DaniilKorshkov/Urania/Urania specs.odt

-Dependencies:

Graphic user interface depends on streamlit for creating web application;

on matplotlib for plotting graphs;

on pandas for creating tables;

Backend depends on pyvisa, python-netdiscover

I recommend running Streamlit GUI through Brave browser instead of Firefox, as Brave do not crash when Streamlit server is stopped

Urania desktop is controlled remotely through RustDesk (free open source analog of TeamViewer). Password and 2FA security policies to be established later

Structure of software:

Sampling system is operated by 2 independent programs that communicate one with another through JSON files.

One program is responsible for data collection (changing sample, operating VSC, inquering data from RGA and Ox. analyzer), another one is responsible for data visualisation and graphic user interface.

Structure of libraries:

The code consists of the following libraries: AbnormalityReaction.py; Functions.py; GUI_Settings_Menu.py; JSONoperators.py; main.py; RGA_comms.py; VSC_comms.py; StreamlitGUI.py, TaskManagement.py, oxygen_analyzer.py, SpectrumsManager.py, VSC_Gui_Operation.py

AbnormalityReaction.py library is responsible for finding abnormalities in mass spectrometer readings and report them to user

FindAbnormalityInSpectrum function inputs a single spectrum as dictionary; date and time of this spectrum; filename of log; filename of file with quality standarts and options

This functions compares each PPM reading for integer molar masses in spectrum to tolerance boundaries set in the quality standarts file.

This function may run in ambient and on-demand mode, depending whether DoReportToJSON is True or False. If True, function is supposed to run right after spectrum is obtained. It reports all abnormalities to JSON log. If False, function is supposed to run on-demand via GUI; and display all abnormalities to user via GUI

Functions.py library contains functions that do not fit into any other library.

get_time_list function inputs list of spectrums and returns list of corresponding moments of time; at which those spectrums were recorded

plot_mass function inputs list of spectrums and desired index; and outputs the list of PPM’s corresponding to given index. For example, it can return all third elements

from list of lists.

GUI_Settings_Menu.py library is responsible for settings menu that runs through graphic user interface. It contains functions to modify JSON settings config that other pages rely on.

reset_to_default function erases currently used JSON config and overwrites it with factiory default JSON config

apply_page_settings function replaces given line in JSON config with desired line. Different lines in JSON config correspond to different pages of GUI. It reads old JSON config and makes full copy of it with exception of desired line; then, overwriting old config with this copy.

modify_* functions input Settings dictionary for given line (obtained before) and Settings filename. Those functions let user change given parameter, and then call apply_page_settings function to make changes to JSON config

Settings_Page function is a ready–to–use Settings menu that runs through Streamlit

JSONoperators.py library is responsible for working with JSON files.

read_spectrum_json function reads all spectrums from JSON file that contains list of spectrums

read_last_spectrums function reads the specified amount of last spectrums from JSON file. It calls read_spectrum_json function and cuts off the unwanted spectrums

read_period_of_time function reads specified amount of spectrums starting from specified moment of time from JSON file. For example, it may read 10 most recent spectrums starting from 01 Jun 2024, 14:00:00.

read_all_page_numbers function reads numbers of all pages that are specified in given JSON config

main.py file runs the main page of graphic user interface

RGA_comms.py library is responsible for sending commands to gas analyser and receiving data from it.

SendPacketsToRGA function inputs a list of str commands. This functions converts those commands to bytes and sends to RGA via TCP protocol.

This function saves all responses from RGA to received_list and returns it.

This function can execute internal commands such as __listen__ or __wait_for_given_mass__. Using those functions, user can control how commands are sent to RGA; and how output is received.

This function raises an error if “ERROR” keyword is detected in output.

GetMassSpectrum function creates a list of prompts for mass spectrometer to receive a mass spectrum with specified initial mass, amount of steps, step length and accuracy. It sends this list of prompts to RGA; receives output, converts the output to required format and

AppendSpectrumJSON function reads specifications (initial mass, amount of steps, step length and accuracy) from metadata in spectrum JSON file; calls GetMassSpectrum to get spectrum and writes this spectrum to JSON file

VSC_comms library is responsible for communication with vaccuum control system

SendCommand function is responsible for sending individual command to vaccuum system controller.

Functions with read and change keyword in this library are responsible for individual actions (open/close/setpoint of single device, read pressure and mass flow of single device and etc.) on connected devices.

ConvertEngineerNotation and ConvertToEngNotation are technical functions, responsible for converting numbers from Python format to format, used by VSC

StabilizePressure is an experimental function that gradually closes an MFC until target pressure is reached at Pressure Controller. Right now there are no plans to use it

IncreaseFlowRate is an experimental function that gradually opens an MFC while maintaining target pressure at Pressure Controller. Right now there are no plans to use it

SmartCloseMFC is a function that partially or fully closes MFC such that pressure on Pressure Controller will not exceed 760 torr. It relies on experimentally obtained function to do so.

FullQuery is a function that displays all data from all sensors.

VSC_Manual_Operation is a program that should be run through terminal with sudo privileges. It displays all data about VSC and lets user manually operate it.

oxygen_analyzer.py library is responsible for inquiring oxygen concentration from oxygen analyzer

GUI_Task_Manager.py is responsible for managing tasks through web application

VSC_Gui_Operation.py is responsible for controlling vsc and multi inlet valve through web application

Technical.py page is responsible for pinging RGA and detecting it’s IP address. It is a separate page for fail safety

StreamlitGUI.py library is responsible for data visualisation through web application.

date_time_input function create widgets for date input and time inputs; allowing user to search for scans made at given moment of time

constant_time_spectrum function plots a graph with molar mass at X axis and PPM at Y axis for specified moment of time. Using slider, user can scroll through different moments of time

constant_time_spectrum_table prints table with numerical value for previous function

constant_mass_spectrum function plots graph with time at X axis and PPM in Y axis for range of specified molar masses. User can input desired molar mass through text input widget

display_one_sample_data function creates a ready-to-use data visualisation page with three different types of graphs displayed. It displays widgets for user to select preferred searching mode (either display most recent spectrums or search for specific moment of time), to select moment of time.

TaskManagement.py library is responsible for managing the task list

GetTaskList name function reads main config and returns name of task list

UpdateTaskList function overwrites previous task list with current one

CheckForEmergencyTasks function checks the task list for emergency task; returns either True,Task_Name or False,None and updates required amount of executions for emergency task

CheckForScheduledTasks function check the task list for scheduled task; returns either True,Task_Name or False,None and updates the most recent execution time for executed task

GetAmountOfASAPTasks reads the task list and gets the amount of regular tasks

GetASAPTask reads the task list; returns the name of required regular task and updates the number of most recently executed task

GetTasks reads the task list; returns name of emergency task if any is there; returns name of scheduled task if any is there; or returns amount of regular task

Structure of JSON files:

Spectrum file format

Spectrum files contain results produced from the same pipe over different moments of time in following format:

{"class":"metadata","valve_number":1,"is_a_spectrum":"True","initial_value":1,"amount_of_scans":4096,"step":0.03125}

{"class":"spectrum","time":x,”oxygen”:y,"array":[x1,x2,x3...]}

Time is formatted as seconds since 01 Jan 1970 using standard Python datetime library

“Metadata” line contains valve_number (position of multi-inlet valve corresponding for this spectrum), "is_a_spectrum":"True" entry for error prevention; “initial_value”, “amount_of_scans” and “step” enrties correspond to parameters of scanning

Array is formatted as Pascals (raw output) for different molar masses starting from “initial_value” with step of “step”

Oxygen is formatted as PPM’s (raw output of oxygen analyser)

GUI settings file format:

GUI settings file consists of multiple lines; each line corresponds to settings of corresponding page.

Following settings of GUI page are specified in each line of settings file:

- page name

- name of spectrum file

- vertical or horizontal orientation

- default masses to be displayed on const_mass graph

- default amount of spectrums to be displayed

- Options whether to display different types of graphs or no

GUI settings has the following format:

{"page_name": "int", "spectrum_filename": "name", "orientation": "vertical"/”horizontal”, "default_amount_of_spectrums": "int", "default_masses": "int1,int2,int3...", "do_display_const_mass": "boolean", "do_display_const_time": "boolean"}

GUI settings line specify which page it belongs to; which JSON file is parsed; whether page is displayed horizontally or vertically; how much spectrums are displayed; what masses are displayed on const_mass graph; whether each type of graphs is displayed

Task list format:

Task list consists of one technical line for memory; and other line correspond to each of the tasks.

{"class": "regular_log", "last_executed": 1} is the technical line that keeps info on last regular task that was executed

{"class": "task", "name": "pipe1", "type": "regular", "valve_position":1, "filename": "Pipe1scan","scans": 10} is the example of Regular task. It contains information of required valve position, on filename in which data would be stored, and the amount of scans.

{"class": "task", "name": "pipe2", "type": "scheduled", “last_execution”:1000, ”freq”:100, "valve_position":1, "filename": "Pipe1scan","scans": 10} is the example of scheduled task. It contains additional information on execution frequency (for example, 100 means 1 execution in 100 seconds) and memory cell that contains last execution time.

{"class": "task", "name": "pipe3", "type": "emergency",”how_much_executions”:5, "valve_position":1, "filename": "Pipe1scan","scans": 10} is the example of emergency task. It contains additional information on amount of executions. If not specified, amount of executions is 1 (task is executed only once and then deleted from task list)
