DaniilKorshkov/Urania/CheatSheetWallpaper.png

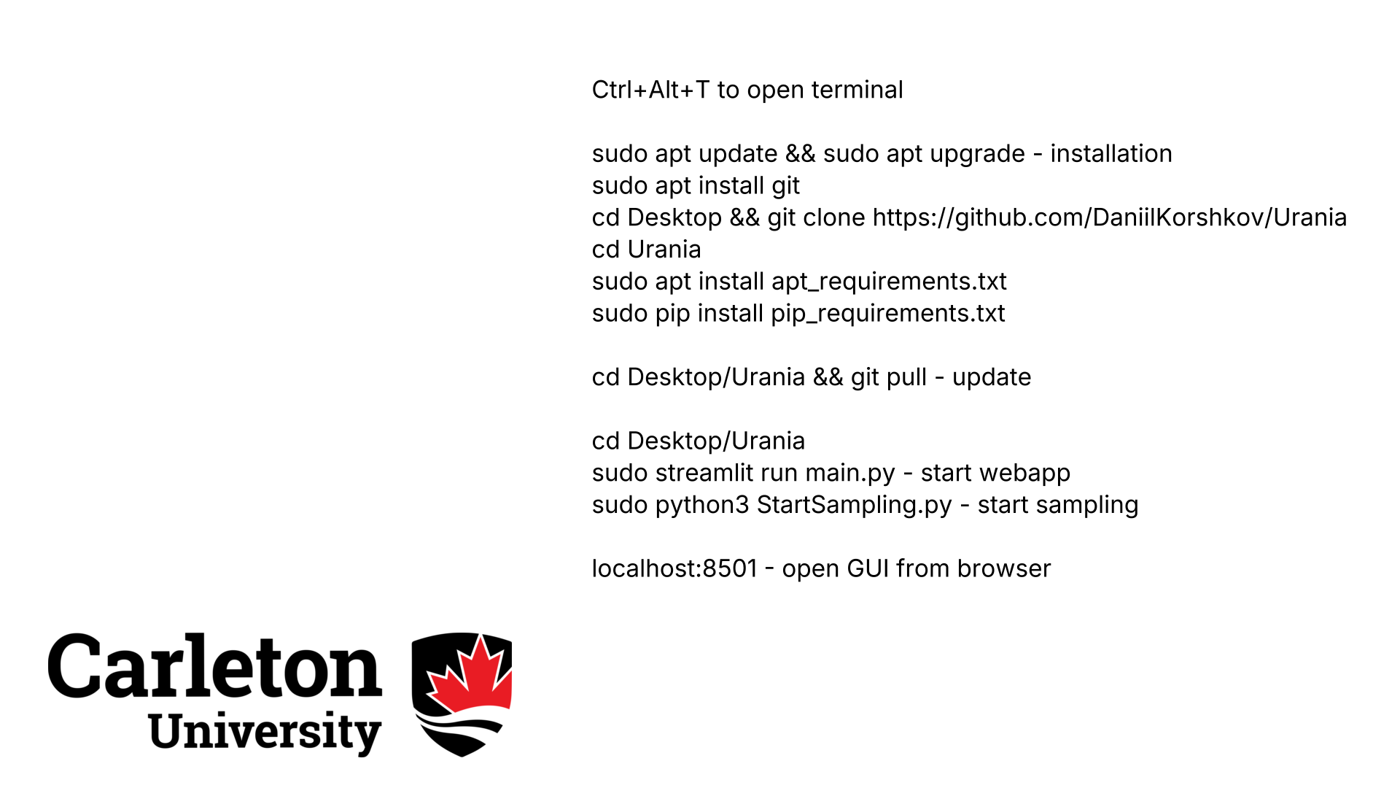
CheatSheetWallpaper.png
