DaniilKorshkov/Urania/Analog sensors calibration.ods

 | Ashcroft pressure transducer
 | PT-05 – PT-06
 | Min V Raw | Max V Raw
 | 0 | 10
 | Min PSIG | Max PSIG
 | -14.7 | 100
 | R Ard Ohm | R Drop Ohm
 | 130 | 130
 | Min V Ard | Max v Ard
 | 0 | 5
 | Min ard bit | Max ard bit
 | 0 | 1023
 | Transducer error PSI |  | R Ard error Ohm | R Drop error Ohm | Arduino read error
 | 0.25 |  | 2.5 | 1.3 | 4
PSI error due to: | 0.25 |  | 0.5735 | 0.5735 | 0.448484848484849
 | Net PSI error | 0.959918308670315
 | Omega pressure transducer
 | PT-01 – PT-04
 | Min A raw | Max A raw
 | 0.004 | 0.02
 | Min PSI | Max PSI
 | 0 | 100
 | R Ohm | 250
 | Min V ard | Max V ard
 | 1 | 5
 | Min ard bit | Max ard bit
 | 204.6 | 1023
 | Transducer error PSI |  | R Ard error Ohm | Arduino read error
 | 0.25 |  | 2.5 | 5
PSI error due to: | 0.25 |  | 1.25 | 0.610948191593353
 | Net PSI error | 1.41359742954322
