DaniilKorshkov/Urania/GasCalibrationEquations.ods

Sheet: main
 |  |  |  |  |  |  |  |  |  |  |  |  |  |  |  |  |  |  |  |  |  |  |  |  |  |  | Produced spectra:
Variables: | He3 | He4 | Ar35 | Ar36 | Ar37 | Ar38 | Ar39 | Ar40 | Ar41 | CH4 12 | CH4 13 | CH4 14 | CH4 15 | CH4 16 | CO2 16 | CO2 28 | CO2 43 | CO2 44 | CO2 45 | N2 14 | N2 27 | N2 28 | O2 16 | O2 31 | O2 32 | M/Z: | 3 | 4 | 12 | 13 | 14 | 15 | 16 | 27 | 28 | 31 | 32 | 35 | 36 | 37 | 38 | 39 | 40 | 41 | 43 | 44 | 45
Coeff: | 0.01 | 0.01 | 0.95 | 0.95 | 0.95 | 0.95 | 0.95 | 0.95 | 0.95 | 0.01 | 0.01 | 0.01 | 0.01 | 0.01 | 0.01 | 0.01 | 0.01 | 0.01 | 0.01 | 0.01 | 0.01 | 0.01 | 0.01 | 0.01 | 0.01 |  | 474.554223608876 | 19364.0283809786 | 9546.08315941665 | 20891.0191799014 | 80956.9483856634 | 544195.506787132 | 731752.362726307 | 3721.48668831949 | 602565.918686123 | 2783.4597550079 | 353148.061588936 | 2689.27076430825 | 294094.16574759 | 594.791014358514 | 59920.1659378875 | 887721.49599294 | 95000000 | 1742.83751430431 | 5196.24301276605 | 749072.767712293 | 8874.06432541684
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
