DaniilKorshkov/Urania/ArduinoSchematics/ArduinoSchematics.kicad_sch

## KiCad design ArduinoSchematics/ArduinoSchematics.kicad_sch (2025-04-13, an earlier design)

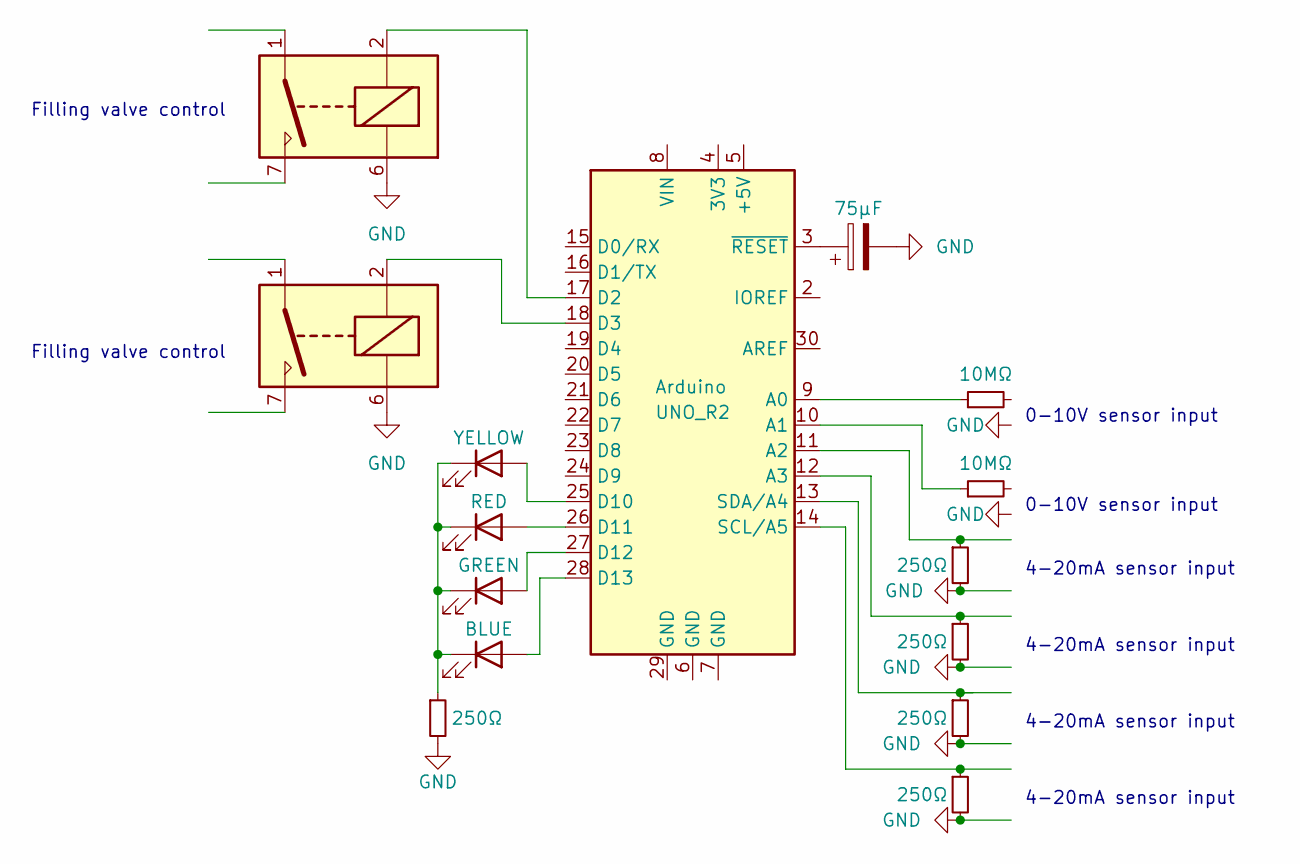
[picture p44: schematic ArduinoSchematics.kicad_sch]

Parts:
Arduino: UNO_R2; Arduino_UNO_R2
BLUE: LED
Capacitor: 75μF; test
GREEN: LED
RED: LED
YELLOW: LED

Connections:
unnamed: Arduino.3 (~RESET), Capacitor.1
unnamed: Arduino.25 (D10), YELLOW.2 (A)
unnamed: Arduino.26 (D11), RED.2 (A)
unnamed: Arduino.27 (D12), GREEN.2 (A)
unnamed: Arduino.28 (D13), BLUE.2 (A)
unnamed: BLUE.1 (K), GREEN.1 (K), RED.1 (K), YELLOW.1 (K)

Notes on the sheet:
4-20mA sensor input
Filling valve control
0-10V sensor input
