DaniilKorshkov/Urania/main.py

import streamlit as st   #main page of webapp. Right now it is effectively a placeholder

import RGA_comms as rc
import StreamlitGUI as sg
import JSONoperators
import datetime


JSONoperators.MergeJSONConfigs("MainConfig","DefaultMainConfig")

st.write("Welcome to Urania sampling system graphic user interface")
st.markdown("")
st.write("Use Currently Processed Scans page on the sidebar to the left to inspect all data currently recorded")
st.write("Use Abnormality Settings page to change PPM threshold, beyond which readings are considered abnormal")
st.write("Use Error Codes page to inspect meanings of error codes")
st.write("Use Manually Inspect Spectrum page to inspect specific data file")
st.write("Use SpectrumsManager page to list all spectrum files; inspect metadata and create new files")
st.write("Use Task Manager to inspect, add or remove tasks for the sampling system")
st.write("Use VSC controls to manually control vacuum control system and multi-inlet valve")
st.write("Use actuator controls to manually control filling station actuators")
st.write("Use filling tracker to inspect filled volume")
st.write("Use VSC Log page to inspect pressure and mass flow data collected by VSC")
st.write("Use Notification Settings page to change notification options for every of the error codes")
st.write("Use Technical page to find RGA IP address, and locate VSC, MIV and OA on USB bus")
st.write("Use RGA Controls page to control pump, heater and capillary heater; and to inquire technical data from RGA")
st.write("Use Main Config to inspect the config file")
st.write("Use Delete Unused Files page to clean logs and remove unused spectrum files")
for i in range(10):
    st.markdown("")
st.write("https://github.com/DaniilKorshkov/Urania")
st.write("Carleton University Physics Department")
st.write("Licensed under GNU GPL v3.0. No rights reserved")
