DaniilKorshkov/Urania/AbnormalityReaction.py

from subprocess import STDOUT

import streamlit as st
import json
import datetime
import os
import JSONoperators as js
import SimpleXChat_Interface as sxci
import Logging
import subprocess
from EmailNotificationSystem import NotifyUser
import SpectraInterpreter





# function to analyse JSON spectrum file for abnormalities and print results to log file
def AnalyseFile(spectrum_filename,MainConfig="MainConfig"):
    handle = open(spectrum_filename, "r")
    abnormalities_detected_in_file = False
    all_log_entries = []

    for line in handle:
        if line == "" or line == "\n" or line[0] == "#":
            continue
        # print(line)
        tempdict = json.loads(line)
        match tempdict["class"]:
            case "metadata":
                metadata = tempdict
                assert metadata["is_a_spectrum"] == "True"
            case "spectrum":
                pass

    handle.close()
    handle = open(spectrum_filename, "r")


    for line in handle:
        if line == "" or line == "\n" or line[0] == "#":
            continue
        # print(line)
        tempdict = json.loads(line)
        match tempdict["class"]:
            case "metadata":
                pass
            case "spectrum":
                abnormalities_detected,log_entries = AnalyseSingleLine(tempdict,metadata["valve_number"],metadata["initial_value"],metadata["step"],spectrum_filename,DoLogging=False)
                if abnormalities_detected:
                    abnormalities_detected_in_file = True
                    for element in log_entries:
                        all_log_entries.append(element)

    handle.close()
    return abnormalities_detected_in_file,all_log_entries



# Function to analyse single spectrum for abnormalities
def AnalyseSingleLine(spectrum_to_analyze,multi_inlet_valve, initial_mass, step, filename, DoLogging=True):



    i = 0
    sound_already_emitted = False

    abnormalities_detected = False
    log_entries = []

    pascal_spectrum = spectrum_to_analyze["array"]
    spectrum = []

    control_spectrum = js.ReadJSONConfig("AbnormalityReaction",f"MIV{multi_inlet_valve}")

    pascal_sum = 0
    for element in pascal_spectrum:
        pascal_sum = pascal_sum + abs(element)
    for element in pascal_spectrum:
        spectrum.append((abs(element) * 1000000) / pascal_sum)


    try:
        oxygen = spectrum_to_analyze["oxygen"]
    except:
        oxygen = 0

    for element in spectrum:
        if int(initial_mass + step*i) == float(initial_mass + step*i):  # only integer peaks are analysed


            try:  # if boundaries for specific mass are specified, those boundaries are used for comparison
                boundaries = control_spectrum[str(f'{int(initial_mass + step * i)}')]
            except:  # else, boundaries are set to default
                boundaries = control_spectrum["default"]



            if element > float(boundaries[1]) or element < float(boundaries[0]):  # if element is smaller than minimal accepted or greater that maximal accepted:
                    abnormalities_detected = True
                    log_entry = f"Valve position {multi_inlet_valve}, Filename {filename}: PPM for M/Z = {int(initial_mass + step * i)} is {element}, while boundaries are {boundaries[0]}:{boundaries[1]}"
                    if DoLogging:
                        Logging.MakeLogEntry(log_entry,log_name="AbnormalityLog")



                        #NotifyUser(,log_entry,False)


                        

                    log_entries.append(log_entry)




        i += 1



    oxygen_boundaries = control_spectrum[str(f'oxygen')]
    if oxygen > float(oxygen_boundaries[1]) or oxygen < float(oxygen_boundaries[0]):
        abnormalities_detected = True
        log_entry = f"Valve position {multi_inlet_valve}, Filename {filename}: PPM for oxygen is {oxygen}, while boundaries are {oxygen_boundaries[0]}:{oxygen_boundaries[1]}"
        if DoLogging:
            Logging.MakeLogEntry(log_entry, log_name="AbnormalityLog")
        log_entries.append(log_entry)


    return abnormalities_detected, log_entries




def AnalyseInterpretedLine(spectrum_to_analyze,multi_inlet_valve,filename, DoLogging=True):



    i = 0
    sound_already_emitted = False

    abnormalities_detected = False
    log_entries = []

    partial_pressures = spectrum_to_analyze["interpreted_spectrum"]
    PPM_dictionary = {}

    control_spectrum = js.ReadJSONConfig("InterpretedAbnormalityReaction",f"MIV{multi_inlet_valve}")

    raw_sum = 0
    for key in partial_pressures:
        raw_sum += abs(partial_pressures[key])
    for key in partial_pressures:
        PPM_dictionary[key] = ((abs(partial_pressures[key]) * 1000000) / raw_sum)


    try:
        oxygen = spectrum_to_analyze["oxygen"]
    except:
        oxygen = 0
    
    PPM_dictionary["O2 electrochemical"] = oxygen

    for key in PPM_dictionary:
            boundaries = control_spectrum[key]
            if PPM_dictionary[key] > float(boundaries[1]) or PPM_dictionary[key] < float(boundaries[0]):  # if element is smaller than minimal accepted or greater that maximal accepted:
                    abnormalities_detected = True
                    log_entry = f"Valve position {multi_inlet_valve}, Filename {filename}: PPM for {key} is {PPM_dictionary[key]}, while boundaries are {boundaries[0]}:{boundaries[1]}"
                    if DoLogging:
                        Logging.MakeLogEntry(log_entry,log_name="AbnormalityLog")


                        if int(multi_inlet_valve) in [13, 14]:
                            NotifyUser("0001", f"Purity of Filling Argon (Lines 13 and 14, RGA/OA) out of spec  {log_entry}",True)
                        elif int(multi_inlet_valve) in range(13):
                            NotifyUser("0003", f" Purity of non-Argon Sampling Point (Lines 1-12, RGA/OA) out of spec:  {log_entry}",False)
                        elif int(multi_inlet_valve) == 15:
                            NotifyUser("0003", f" Purity of non-Argon Sampling Point (Lines 1-12, RGA/OA) out of spec:  {log_entry}",False)

                        

                    log_entries.append(log_entry)



    return abnormalities_detected, log_entries



def AnalyzeInterpretedFile(spectrum_filename,MainConfig="MainConfig"):
    handle = open(spectrum_filename, "r")
    abnormalities_detected_in_file = False
    all_log_entries = []

    for line in handle:
        if line == "" or line == "\n" or line[0] == "#":
            continue
        # print(line)
        tempdict = json.loads(line)
        match tempdict["class"]:
            case "metadata":
                metadata = tempdict
                assert metadata["is_a_spectrum"] == "True"
            case "spectrum":
                pass

    handle.close()
    handle = open(spectrum_filename, "r")


    for line in handle:
        if line == "" or line == "\n" or line[0] == "#":
            continue
        # print(line)
        tempdict = json.loads(line)
        match tempdict["class"]:
            case "metadata":
                pass
            case "spectrum":

                try:
                    void = tempdict["interpreted_spectrum"]
                    spectrum_is_interpreted = True
                except:
                    spectrum_is_interpreted = False

                
                
                
                if (spectrum_is_interpreted == False) and (metadata["initial_value"] == 1) and (metadata["amount_of_scans"] == 50) and (metadata["step"] == 1):
                    interpreted_spectrum = SpectraInterpreter.solve_mass_spectrum(tempdict["array"])
                    tempdict["interpreted_spectrum"] = interpreted_spectrum
                    spectrum_is_interpreted = True

                if spectrum_is_interpreted == True:

                    abnormalities_detected,log_entries = AnalyseInterpretedLine(tempdict,metadata["valve_number"],spectrum_filename,DoLogging=False)
                    if abnormalities_detected:
                        abnormalities_detected_in_file = True
                        for element in log_entries:
                            all_log_entries.append(element)
                
                else:
                    pass
                

    handle.close()
    return abnormalities_detected_in_file,all_log_entries



#  vsc_pressure_dictionary = { "pg_pressure":760, "mfc_flow":100, "pc_pressure":760, "mfm_flow":100, "filling_mfm_flow":1000     }

def AnalyzeVSCLine(dictionary, SamplingLine = 1, CurrentlySampling = False, DoLogging=True):

    log_entries = []
    control_spectrum = js.ReadJSONConfig("InterpretedAbnormalityReaction",f"VSC")

    code8 = False #PC pressure deviation
    code9 = False #PC pressure critically low
    code10 = False #PC pressure critically high
    code11 = False #PC pressure critically low (lines 13-14)

    code12 = False #MFMF flow critically low
    code13 = False #MFMF pressure critically low

    code14 = False

    for key in dictionary:

        

        match key:
            #case "pg_pressure":
             #   boundaries = control_spectrum["PT"]
            #case "mfc_flow":
             #   boundaries = control_spectrum["MFC"]
            case "pc_pressure":
                boundaries = control_spectrum["CS-PC-01"]
            case "mfm_flow":
                boundaries = control_spectrum["CS-FM-01"]
            case "filling_mfm_flow":
                boundaries = control_spectrum["FS-FM"]
            case default:
                continue





        if key == "pc_pressure":

            if CurrentlySampling:
                if (dictionary[key] > boundaries[2]) or (dictionary[key] < boundaries[1]):
                    code8 = True
                    if DoLogging:
                        log_entries.append(f"PC pressure = {dictionary[key]} while boundaries are {boundaries[1]} - {boundaries[2]}")
                        NotifyUser("0008", f"PC Pressure {dictionary[key]} while boundaries are {boundaries[1]} - {boundaries[2]}",False)
            
            if (SamplingLine != 13) and (SamplingLine != 14):
                if (dictionary[key] < boundaries[0]):
                    code9 = True
                    if DoLogging:
                        log_entries.append(f"PC pressure = {dictionary[key]} is critically low (min: {boundaries[0]})")
                        NotifyUser("0009", f"PC pressure = {dictionary[key]} is critically low (max: {boundaries[3]})",False)

            if (SamplingLine == 13) or (SamplingLine == 14):
                if (dictionary[key] < boundaries[0]):
                    code11 = True
                    if DoLogging:
                        log_entries.append(f"PC pressure = {dictionary[key]} is critically low (min: {boundaries[0]})")
                        NotifyUser("0011", f"PC pressure = {dictionary[key]} is critically low (max: {boundaries[3]})",True)



            
            if (dictionary[key] > boundaries[3]):
                code10 = True
                if DoLogging:
                    log_entries.append(f"PC pressure = {dictionary[key]} is critically high (max: {boundaries[3]})")
                    NotifyUser("0010", f"PC pressure = {dictionary[key]} is critically high (max: {boundaries[3]})",True)
            

        if key == "filling_mfm_flow":
            if (dictionary[key] < boundaries[0]):
                code12 = True
                if DoLogging:
                    log_entries.append(f"Filling station flow = {dictionary[key]} is critically low (min: {boundaries[0]})")
                    NotifyUser("0012", f"Filling station flow = {dictionary[key]} is critically low (min: {boundaries[0]})",True)
            
        if key == "mfm_flow":
            if (dictionary[key] < boundaries[0]):
                code13 = True
                if DoLogging:
                    log_entries.append(f"Sampling MFM flow = {dictionary[key]} is critically low (min: {boundaries[0]})")
                    NotifyUser("0013", f"Sampling MFM flow = {dictionary[key]} is critically low (min: {boundaries[0]})",False)
        
        if key == "mfc_flow":
            if (dictionary[key] < boundaries[0]):
                code14 = True
                if DoLogging:
                    log_entries.append(f"Sampling MFC flow = {dictionary[key]} is critically low (min: {boundaries[0]})")
                    NotifyUser("0014", f"Sampling MFC flow = {dictionary[key]} is critically low (min: {boundaries[0]})",False)
            


    return code8, code9, code10, code11, code12, code13, code14, log_entries

#def MakeLogEntry()







#AnalyseSpectrum("FullScan","ControlSpectrumTest","AbnormalityLog",True)
def AnalyzeArduinoLine(dictionary, SamplingLine = 1, CurrentlySampling = False, DoLogging=True):

    log_entries = []
    control_spectrum = js.ReadJSONConfig("InterpretedAbnormalityReaction",f"Arduino")

    code17 = False #PC pressure deviation
    
    for key in dictionary:

        

        
        boundaries = control_spectrum[key]
            





        if key == "FS-PT-02":

            

            
            if (dictionary[key] > boundaries[2]) or (dictionary[key] < boundaries[1]):
                code10 = True
                if DoLogging:
                    log_entries.append(f"PT-02 pressure = {dictionary[key]} while boundaries are {boundaries[1]} - {boundaries[2]}")
                    NotifyUser("0017", f"PT-02 pressure = {dictionary[key]} while boundaries are {boundaries[1]} - {boundaries[2]}",True)
            

        
    return code17, log_entries

#def MakeLogEntry()
