DaniilKorshkov/Urania/TaskManagement.py

import json
import datetime

import Logging
import Logging as lg
import JSONoperators as js
import VSC_comms
import servo_motor
import RGA_comms
import VSC_comms as vsc
import time
import os
import AbnormalityReaction as ar
import subprocess
from EmailNotificationSystem import NotifyUser
import ArduinoComms
import signal


"""def TimeoutHandler():
    Logging.MakeLogEntry("Timeout in TaskManagement")
    raise Exception("Timeout")"""

def GetTasklistName(config="MainConfig"):  #function to get name of task list from main config
    tasklist_name = None
    handle = open(config, "r")
    for line in handle:

        if line == "" or line == "\n" or line[0] == "#":
            continue

        dict_line = json.loads(line)
        if dict_line["class"] == "tasks":
            tasklist_name = dict_line["TaskList"]
            default_tasklist_name = dict_line["DefaultTaskList"]
            break
    handle.close()
    return tasklist_name, default_tasklist_name

def UpdateTaskList(tasklist_name,text_to_append):

        handle = open(tasklist_name,"w")
        i = 1
        for line in text_to_append:
            handle.write(line)
            if i < len(text_to_append):
                handle.write("\n")
            i += 1

        handle.close()

def CheckForEmergencyTasks(config="MainConfig"):  #function that reads task list for emergency tasks. Returns True,task_name or False,None
    tasklist_name = js.ReadJSONConfig("tasks","TaskList")

    if tasklist_name == None:
        raise NameError("Task List is not specified in Main Config")

    text_copy = []
    if_task_found = False
    task_to_execute = None

    handle = open(tasklist_name, "r")
    for line in handle:

        if line == "" or line == "\n" or line[0] == "#":   #skip empty lines
            continue

        dict_line = json.loads(line)
        if dict_line["class"] == "task" and dict_line["type"] == "emergency" and not if_task_found:

            try:   # evaluation of executiuon times.
                match dict_line["how_much_executions"]:
                    case "inf":  #infinite executions case
                        text_copy.append(line.strip("\n"))
                        if_task_found = True
                        task_to_execute = dict_line["name"]
                    case 0:  #if 0 execution time left, task is no longer appended to txt file and is deleted
                        pass
                    case _:  # else, howmuchexecutions is decremented by 1
                        howmuchexecutions = int(dict_line["how_much_executions"])-1
                        dict_line["how_much_executions"] = howmuchexecutions
                        text_copy.append(json.dumps(dict_line))
                        if_task_found = True
                        task_to_execute = dict_line["name"]
            except:  #if dict_line["how_much_executions"] not found, it is considered to be 1
                pass
        else:
            text_copy.append(line.strip("\n"))
    handle.close()

    if if_task_found:  # TaskList updated
        UpdateTaskList(tasklist_name,text_copy)

    return if_task_found,task_to_execute

def CheckForScheduledTasks(config="MainConfig"): #function that reads task list for scheduled tasks. Returns True,task_name or False,None

    tasklist_name = js.ReadJSONConfig("tasks", "TaskList")

    if tasklist_name == None:
        raise NameError("Task List is not specified in Main Config")

    current_time = int(datetime.datetime.now().timestamp())
    task_to_execute = None
    if_scheduled_tasks = False

    text_copy = []

    handle = open(tasklist_name,"r")
    for line in handle:

        if line == "" or line == "\n" or line[0] == "#":
            continue

        dict_line = json.loads(line)
        if dict_line["class"] == "task" and dict_line["type"] == "scheduled" and (not if_scheduled_tasks):
            if int(dict_line["last_execution"])+int(dict_line["freq"]) < current_time:
                task_to_execute = dict_line["name"]
                dict_line["last_execution"] = int(datetime.datetime.now().timestamp()) # if scheduled task is found, execution time is updated
                if_scheduled_tasks = True


        text_copy.append(json.dumps(dict_line))

    handle.close()

    if if_scheduled_tasks:  # TaskList updated
        UpdateTaskList(tasklist_name, text_copy)

    return if_scheduled_tasks,task_to_execute


def GetAmountOfRegularTasks(config="MainConfig"):  # function to get amount of regular tasks

    tasklist_name = js.ReadJSONConfig("tasks","TaskList")
    if tasklist_name == None:
        raise NameError("Task List is not specified in Main Config")

    handle = open(tasklist_name)
    regular_tasks_count = 0

    for line in handle:

        if line == "" or line == "\n" or line[0] == "#":
            continue

        dict_line = json.loads(line)
        if dict_line["class"] == "task":
            if dict_line["type"] == "regular":
                regular_tasks_count += 1

    handle.close()
    return regular_tasks_count


def GetRegularTask(config="MainConfig"):  #function to get regular task name

    text_copy = []

    tasklist_name = js.ReadJSONConfig("tasks", "TaskList")
    if tasklist_name == None:
        raise NameError("Task List is not specified in Main Config")
    task_amount = GetAmountOfRegularTasks(config)

    if task_amount == 0:
        return False, None
    else:
        if_tasks_found = True


        handle = open(tasklist_name,'r')
        for line in handle:
            if line == "" or line == "\n" or line[0] == "#":
                continue
            dict_line = json.loads(line)
            if dict_line["class"] == "regular_log":
                current_task_number = (dict_line["last_executed"] + 1) % task_amount  #number of previously executed task updated
                dict_line["last_executed"] = current_task_number
                text_copy.append(json.dumps(dict_line))
            else:
                text_copy.append(line.strip("\n"))

        handle.close()

        i=0

        handle = open(tasklist_name,'r')
        for line in handle:

            if line == "" or line == "\n" or line[0] == "#":
                continue

            dict_line = json.loads(line)
            if dict_line["class"] == "task":
                if dict_line["type"] == "regular":
                    if i == current_task_number:
                        task_to_execute = dict_line["name"]
                    i += 1
        handle.close()

        UpdateTaskList(tasklist_name, text_copy)

        return if_tasks_found,task_to_execute



def GetTask(config="MainConfig"):  # function that checks for emergency tasks; for scheduled tasks, for regular tasks and returns name of required task

    tasklist_name = js.ReadJSONConfig("tasks","TaskList")
    default_tasklist_name = js.ReadJSONConfig("tasks","DefaultTaskList")
    js.assert_file_exists(tasklist_name, default_tasklist_name)

    ifemergencytasks, taskname = CheckForEmergencyTasks(config)
    if not ifemergencytasks:
        ifscheduledtasks, taskname = CheckForScheduledTasks(config)
        if not ifscheduledtasks:
            ifregulartasks, taskname = GetRegularTask(config)



    return taskname

def GetTaskData(taskname, config="MainConfig"):

    tasklist_name = js.ReadJSONConfig("tasks", "TaskList")
    default_tasklist_name = js.ReadJSONConfig("tasks", "DefaultTaskList")
    js.assert_file_exists(tasklist_name, default_tasklist_name)

    handle = open(tasklist_name)
    for line in handle:
    	
        if line == "" or line == "\n" or line[0] == "#":
            continue
    	
        dict_line = json.loads(line)
        try:
            if dict_line["name"] == taskname:
                spectrum_filename = dict_line["filename"]
                amount_of_scans = dict_line["scans"]
                valve_position = dict_line["valve_position"]
                accuracy = dict_line["accuracy"]
                purge_cycles = dict_line["purge_cycles"]
                try:
                    mass_flow = int(dict_line["mass_flow"])
                except:
                    mass_flow = "default"




                break
        except:
            pass
    handle.close()

    return spectrum_filename,amount_of_scans, valve_position, accuracy, purge_cycles, mass_flow



def MakeScan(filename,valve_number,amount_of_scans, accuracy, purge_cycles, mass_flow):
    #signal.signal(signal.SIGALRM, TimeoutHandler())
    #global interrupted
    #critical_errors = False


    try:
        servo_motor.switch_valve_position(valve_number)
        lg.MakeLogEntry(f"Multi inlet valved switched to position {valve_number}")
    except:

        NotifyUser("0015", f"Multi Inlet Valve control failure (Event 0015)",True)

        RGA_comms.rga_filament_control("Off")
        ArduinoComms.FillingActClose()


        lg.MakeLogEntry(f"Sampling terminated as multi inlet valve is not responding")
        return True


    









    vsc.ChangeMFCMode("Open")
    
    try:
        for i in range(purge_cycles):
            ArduinoComms.SamplingActOpen()

            try:
                vsc_data = VSC_comms.LogVSCData()
                code8, code9, code10, code11, code12, code13, code14, void = AnalyzeVSCLine( vsc_data, valve_number, False, DoLogging=True )
            
                if code10 == True:
                    RGA_comms.rga_filament_control("Off")
                    ArduinoComms.FillingActClose()
                    return True

                if (code11 == True) or (code12 == True):
                    ArduinoComms.FillingActClose()
                    
            
            
            
            except:
                NotifyUser("0007", f"VSC Communication/Control Failure (0007)", False)
                Logging.MakeLogEntry("Failed to log VSC data")
            try:
                ArduinoComms.LogArduinoData()
            except:
                #NotifyUser("0011", f"Arduino pressure reading failure (Event 0011)", False)
                Logging.MakeLogEntry("Failed to reach Arduino board for recording temperature and pressure")

            time.sleep(35)
            ArduinoComms.SamplingActClose()
            time.sleep(30)

        

        try:
            VSC_comms.LogVSCData("MainConfig")
        except:
            NotifyUser("0007", f"VSC Communication/Control Failure (0007)", False)
            Logging.MakeLogEntry("Failed to log VSC data")

        try:
            ArduinoComms.LogArduinoData()
        except:
            NotifyUser("0016", f"Arduino pressure reading failure (Event 0016)", False)
            Logging.MakeLogEntry("Failed to reach Arduino board for recording temperature and pressure")



    except:

        NotifyUser("0011", f"Arduino actuator control failure (Event 0011)", True)

        lg.MakeLogEntry(f"Sampling failed due to purging actuator")
        return True




    lg.MakeLogEntry(f"Purge finalized")

    


    try:
        if mass_flow != "default":
            print(f"Required flow fetched as {mass_flow}")
            required_flow = int(mass_flow)
            
        else:
            required_flow = (js.ReadJSONConfig("vsc","flow_rate_list"))[  (int(valve_number)-1)  ]
            print(f"Default flow used: {required_flow}")

        if required_flow == 0:
            ArduinoComms.SamplingActClose()
            print(f"Sampling actuator closed")
        else:
            ArduinoComms.SamplingActOpen()
            vsc.ChangeMFCFlowRate(required_flow)
            vsc.ChangeMFCMode("Setpoint")
            print(f"Sampling actuator opened, flow set to {required_flow}")

        lg.MakeLogEntry(f"Flow changed to {required_flow} SCCM")
    except:

        NotifyUser("0007", f"VSC Communication/Control Failure",True)

        RGA_comms.rga_filament_control("Off")
        ArduinoComms.FillingActClose()


        lg.MakeLogEntry(f"Sampling terminated as VSC is not responding")
        return True


    time.sleep(60)

    initial_time = int(datetime.datetime.now().timestamp())
    while int(datetime.datetime.now().timestamp()) < (initial_time + amount_of_scans + 1):
        try:
            
            spectrum_to_analyze, intital_mass, step, ErrorMessage = RGA_comms.AppendSpectrumJSON(filename, accuracy=accuracy)

            if (ErrorMessage != None) and (ErrorMessage != "TIMEOUT") and (not ("Failed to create measurement" in str(ErrorMessage))) and (not ("LinkDown" in ErrorMessage)):
                critical_errors = True
                NotifyUser("0006", f"Shutting down: RGA Communication/Sampling Failure (Event 0006): {ErrorMessage}", True)
                lg.MakeLogEntry(f"Sampling terminated due to RGA error: {ErrorMessage}")
                break


            elif ErrorMessage != None:
                if "Failed to create measurement" in str(ErrorMessage):
                    lg.MakeLogEntry(f"Sampling failed due to 500: Failed To Create Measurement error; repeating attempt")
                if "LinkDown" in str(ErrorMessage):
                    lg.MakeLogEntry(f"Sampling failed due to LinkDown Serial error; repeating attempt")
                if str(ErrorMessage) == "TIMEOUT":
                    lg.MakeLogEntry(f"Sampling failed due to TIMEOUT error (probable packet loss); repeating attempt")

                NotifyUser("0006", f"Repeating attempt: RGA Communication/Sampling Failure, (Event 0006): {ErrorMessage}", False)




            else:


                if valve_number != 16:
                    try:
                        if_abnormalities, void = ar.AnalyseInterpretedLine(spectrum_to_analyze,valve_number,filename)
                        if if_abnormalities:
                            Logging.MakeLogEntry(f"Abnormal readings were found for Filename = {filename} scan. Check AbnormalityLog for details")

                            auto_close = js.ReadJSONConfig("InterpretedAbnormalityReaction","auto_close")

                            if (valve_number == 14) and (auto_close == "True"):
                                try:
                                    ArduinoComms.TurnActuatorOneOff()
                                    lg.MakeLogEntry(f"Filling station actuator closed due to abnormal readings on line 14")
                                except:
                                    NotifyUser("0002", f"!!! URGENT ATTENTION REQUIRED !!! Argon purity out of spec & automatic shutdown failed Fail (Event 0002)",True)
                                    lg.MakeLogEntry(f"Filling station actuator FAILED TO closed due to abnormal readings on line 14")

                    except:
                        lg.MakeLogEntry(f"Abnormality scan for Filename = {filename} crashed with error")
                else:
                    if_abnormalities = False




        except:
            lg.MakeLogEntry(f"Sampling terminated due to unknown RGA error")
            return True





        try:
            VSC_comms.LogVSCData("MainConfig")
        except:
            Logging.MakeLogEntry("Failed to log VSC data")

        try:
            ArduinoComms.LogArduinoData()
        except:
            Logging.MakeLogEntry("Failed to reach Arduino board for recording temperature and pressure")

        time.sleep(10)

    return False



def DoTask(config="MainConfig"):
    taskname = GetTask(config)

    if taskname == None:
        lg.MakeLogEntry(f"Sampling terminated due to empty task list\n")
        return True
    else:

        lg.MakeLogEntry(f"Task {taskname} initiated")

        handle = open("__currenttaskname__","w")
        handle.write(taskname)
        handle.close()

        spectrum_filename, amount_of_scans, valve_position, accuracy, purge_cycles, mass_flow  = GetTaskData(taskname,config)
        print(f"mass flow: {mass_flow}")
        critical_errors = MakeScan(spectrum_filename, valve_position, amount_of_scans, accuracy, purge_cycles, mass_flow)

        os.system("rm __currenttaskname__")

        if not critical_errors:
            lg.MakeLogEntry(f"Task {taskname} finished without errors\n")
        else:
            lg.MakeLogEntry(f"Task {taskname} finished with error\n")

            





        return critical_errors
