DaniilKorshkov/Urania/(commit log)

2024-09-18 Added dashboard for currently processed scans
2024-10-08 Placed command to select multiplier into the correct position
    [RGA_comms.py]
2024-10-09 Fixed bug where flow rate was displayed in torr in VSC page. Made RGA IP netdiscover more informative
    [RGA_comms.py, VSC_Gui_Operation.py]
2024-11-18 Description of gas flowchart added to user manual
2024-11-21 Photos that describe flowchart added
2025-01-13 Bug fixes for VSC data logging
    [JSONoperators.py]
2025-01-24 Fixed minor bugs with task manager braking on empty lines in task list. Removed buttons that turn on filament
    [RGA_comms.py, TaskManagement.py]
2025-01-28 Modified mass spectrum recording process such that low current is scanned with multiplier, high current is scanned with faraday cup
2025-01-28 Fixed minor syntaxis bugs
    [RGA_comms.py]
2025-02-04 Menu to control valve moved to top of the page. Added more options to inquire data from RGA
2025-02-06 Fixed filament turning on and off. Now current task is displayed in RGA web menu
    [RGA_comms.py, TaskManagement.py]
2025-02-11 Modified program such that all settings stored in MainConfig. MainConfig no longer tracked on Git. DefaultMainConfig is tracked instead, systems falls back to DefaultMainConfig if some entries miss i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
    [GUI_settings_menu.py, JSONoperators.py, StartSampling.py, StreamlitGUI.py, TaskManagement.py, main.py]
2025-02-13 Added tracemalloc
2025-02-13 vsc log no longer tracked by git. assert_file_exist added to handle it
    [GUI_Task_Manager.py, VSC_comms.py]
2025-02-14 Fixed minor bugs for abnormality analysis
    [AbnormalityReaction.py, GUI_File_Manager.py, TaskManagement.py]
2025-02-18 Unknown errors were caused by inproper naming of RGA (Error 204 if two peaks of similar names are encountered)
    [RGA_comms.py, TaskManagement.py]
2025-02-18 Fixed bug with too long SingleSpectrum names
    [RGA_comms.py, main.py]
2025-02-18 If oxygen data not found, fall back to O2=0. Solved uppercase/lowercase syntaxis bug. Correctly specified conditions for logging
    [AbnormalityReaction.py, Logging.py]
2025-02-18 Solved conflict with 'Logging' name
    [AbnormalityReaction.py]
2025-02-19 Timeout error do not result in sampling termination
    [RGA_comms.py, TaskManagement.py]
2025-02-20 Added icons to notifications. Added email notifications (need to finalize after we get email address). Fixed typo with 'wrtie'
    [AbnormalityReaction.py, EmailNotificationSystem.py, StartSampling.py, TaskManagement.py]
2025-02-23 Added handling of Error 500
    [TaskManagement.py]
2025-02-24 Fixed RGA info inquiry commands. Removed sorting of list as they are already sorted, and sorting has O(xlnx) complexity
    [JSONoperators.py]
2025-02-26 Hotfix for notify-send not working as root
    [AbnormalityReaction.py, EmailNotificationSystem.py, StartSampling.py, TaskManagement.py]
2025-02-26 if string in None error resolved
    [TaskManagement.py]
2025-03-21 Release message is sent until confirmation received. Added code for arduino board
2025-03-25 Added kicad arduino schematics
    [ArduinoSchematics.kicad_pcb, ArduinoSchematics.kicad_sch]
2025-03-27 Fixed 'shedule' and 'scheduled' typo
    [TaskManagement.py]
2025-03-27 Fixed bug with error message if displaying ConstTime of empty spectrum
    [StreamlitGUI.py]
2025-04-01 Added support for arduino filling station readings
2025-04-02 Added switch to schematics
    [ArduinoSchematics.kicad_sch]
2025-04-02 More detailed comments for arduino firmware; changed position of GetArduinoData commands
2025-04-07 Added timeout for servo motor, fixed emergency task reference before assignment bug, increased RGA recon accuracy from 0 to 2
    [RGA_comms.py, TaskManagement.py, servo_motor.py]
2025-04-09 Fixed labels and mass string interpreting
    [StreamlitGUI.py]
2025-04-10 Attempt to fix LingSerial Down
    [ArduinoFirmware.ino, EmailNotificationSystem.py, RGA_comms.py, TaskManagement.py]
2025-04-10 New schematics
    [ArduinoSchematics.kicad_sch]
2025-04-13 added AC power supply, converter and actuator to schematic
    [ArduinoSchematics.kicad_sch]
2025-04-15 Added numerical integration for filling mass flow meter
2025-04-16 Reverted changes to RGA_comms due to unknown bug in later commits
    [RGA_comms.py]
2025-04-22 Extended error message in log
    [TaskManagement.py]
2025-05-07 removed settings page, removed unused functionality, better error codes
    [GUI_File_Manager.py, GUI_Task_Manager.py, JSONoperators.py, StreamlitGUI.py, main.py]
2025-05-07 Replaced currently processed task to task menu
    [GUI_Task_Manager.py]
2025-05-12 Changed naming of pressure gauge to pressure transducer
2025-05-14 Changed pressure buildup time to 30s
2025-05-28 Simplified return of True or False for critical errors
    [StartSampling.py, TaskManagement.py]
2025-05-28 Added all necessary scripts for arduino board
2025-05-29 Spreadsheet for analog sensor error propagation
    [Analog sensors calibration.ods]
2025-05-30 Solved crash if two programs try to communicate with one USB device. Added option to close actuator if abnormal readings are found
    [ArduinoComms.py, TaskManagement.py, VSC_Gui_Operation.py, VSC_comms.py, oxygen_analyzer.py, servo_motor.py]
2025-06-05 Fixed typo in config and added better lock handling
    [ArduinoComms.py, VSC_comms.py, oxygen_analyzer.py, servo_motor.py]
2025-06-11 Removed USB logging due to linkdown serial being resolved
    [ArduinoComms.py, VSC_comms.py, oxygen_analyzer.py, servo_motor.py]
2025-06-13 One pin for controlling actuators instead of two. As an experiment, added opening and closing of actuator during purging
2025-06-20 Changed polynomes for arduino; minor fixes
    [servo_motor.py]
2025-07-09 Resistor template for openscad
    [ResistorTemplate.scad]
2025-07-11 Tools for converting raw mass spectra into particle concentrations
    [IsotopesAndParticlesList.ods]
2025-07-15 ionic current is divided over pressure
    [IsotopesAndParticlesList.ods]
2025-07-15 RGA readings are divided over internally measured pressure
2025-07-15 Forgot to divide RGA readings by pressure
2025-07-16 Fixed identation for Arduino GUI and added mock cracking patterns
    [VSC_Gui_Operation.py]
2025-07-18 Removed noice parameter from interpreter. Minor changes to GUI. Arduino makes 10 analog reads instead of 1
2025-07-18 Typos in ArduinoComms
2025-07-21 chart for calibrating cracking patterns
    [GasCalibrationEquations.ods]
2025-07-24 Added calibration for CO2
    [GasCalibrationEquations.ods]
2025-07-25 Spectral interpreter relies on major peaks only
    [GasCalibrationEquations.ods]
2025-07-28 Added calibration to config file
2025-08-05 custom amount of voltage readings, specified in config
2025-08-25 Added concentration spreadsheet
    [Concentration expected confidence interval.ods]
2025-09-03 Added Django notification script
    [Concentration expected confidence interval.ods]
2025-09-08 Changed purging from MFC based to actuator based. More clear names for actuator functions. Modified PurgeTest function
2025-11-06 More error codes added
    [AbnormalityReaction.py, JSONoperators.py, StartSampling.py, StreamlitGUI.py, TaskManagement.py, VSC_comms.py]
2025-11-07 Added page for error code management and minor syntaxis
    [AbnormalityReaction.py, TaskManagement.py, VSC_comms.py, oxygen_analyzer_to_csv.py]
2025-11-11 Finished bulk part of error code implementation
    [AbnormalityReaction.py, EmailNotificationSystem.py, StreamlitGUI.py, TaskManagement.py]
2025-11-25 Added support for custom flow for every gas line
2026-05-11 Sample of input-output handling for .ROOT concentration calculator
2026-05-19 Documents on PPM calculation and RGA calibration appended
2026-05-25 Example of calibration equation solution
2026-06-08 Compiled working program that resolves RGA patternt via TH1D.Fit method
    [spectre_to_ppm_converter_th1d_fit.C]
2026-06-09 Parameters of calibration matrx are not hard coded
2026-06-10 ROOT TH1D script to calibrate RGA
2026-06-12 Calibration with respect to daily RGA sensitivity
2026-06-15 Modified calibration script to accept arbitrary input
2026-06-16 Working calibration/interpretation cycle, figure out numeric stability for large PPM'sgit add spectre_to_ppm_converter_th1d_fit.C calibration_calculator_th1d_fit.C SpectraInterpreter.py !
    [SpectraInterpreter.py, calibration_calculator_th1d_fit.C, spectre_to_ppm_converter_th1d_fit.C]
2026-07-28 Suppord for third actuator
2026-07-28 added support for third actuator
2026-08-04 renamed filling station to actuator control; renamed actuator control(old) to VSC control
2026-08-06 might fixed tickmarks for log scale
    [StreamlitGUI.py]
2026-08-06 Pressure relief station typo
2026-08-06 Actuator open during sampling. MFC always setpoint. Added support for custom flow rate
2026-08-07 mass flow passed to task creation
2026-08-07 proper nesting to add mass flow to task
2026-08-19 save mass flow as int
2026-08-19 save mass flow as integer
2026-08-31 changed pressure transducers indexes
2026-09-09 Changed naming conventions for VSC elements and pressure transducers
2026-09-28 calibration function
